tganamur/Tripod-TermProject/TestBuild/Core/Src/main.cpp

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
/* Includes ------------------------------------------------------------------*/
#include "main.h"

/* USER CODE BEGIN Includes */
#include <stdio.h>
#include "bno055.h"
#include "tmc4210.h"
#include  "dcMotorDriver.h"
/* USER CODE END Includes */

I2C_HandleTypeDef hi2c1;

SPI_HandleTypeDef hspi1;
SPI_HandleTypeDef hspi2;

TIM_HandleTypeDef htim1;
TIM_HandleTypeDef htim2;
TIM_HandleTypeDef htim3;

UART_HandleTypeDef huart1;
UART_HandleTypeDef huart2;

/* USER CODE BEGIN PV */
char recvBuf[8] = {0};
char test = 0;
/* USER CODE END PV */

void SystemClock_Config(void);
static void MX_GPIO_Init(void);
static void MX_TIM2_Init(void);
static void MX_USART1_UART_Init(void);
static void MX_SPI1_Init(void);
static void MX_I2C1_Init(void);
static void MX_SPI2_Init(void);
static void MX_TIM1_Init(void);
static void MX_USART2_UART_Init(void);
static void MX_TIM3_Init(void);
/**
  * @brief  The application entry point.
  * @retval int
  */
int main(void)
{
  /* USER CODE BEGIN 1 */
	//HAL_UART_Receive_IT(&huart2, (uint8_t*)recvBuf, 1);
  /* USER CODE END 1 */

  /* MCU Configuration--------------------------------------------------------*/

  /* Reset of all peripherals, Initializes the Flash interface and the Systick. */
  HAL_Init();

  /* Configure the system clock */
  SystemClock_Config();

  /* Initialize all configured peripherals */
  MX_GPIO_Init();
  MX_TIM2_Init();
  MX_USART1_UART_Init();
  MX_SPI1_Init();
  MX_I2C1_Init();
  MX_SPI2_Init();
  MX_TIM1_Init();
  MX_USART2_UART_Init();
  MX_TIM3_Init();
  /* USER CODE BEGIN 2 */
/*!
 * bno055 device address and opmode register address
 * 0x08 -> data to be written into opmode reg. to configure in IMU mode
 */
  HAL_TIM_PWM_Start(&htim1, TIM_CHANNEL_1);
  uint32_t IMU_opmode_addr = 0x3D;
  uint8_t  IMU_mode[1] = {0x08};

  //!uart transmit buffer
  char uart_buf1[128];


  //!create IMU object & associated vars
  bno055* imu;
  imu = new bno055(&hi2c1);
  imu->write(IMU_opmode_addr, IMU_mode, 1);
  int16_t eulx = 0;
  int16_t euly = 0;
  int16_t eulz = 0;

  //!create tmc4210 object & associated vars
  tmc4210* stepper;
  stepper = new tmc4210(&hspi1, &htim1, SPI1_CS1_Pin, EN1_Pin);
  stepper->setup();

  tmc4210* stepper2;
  stepper2 = new tmc4210(&hspi1, &htim1, SPI1_CS2_Pin, GPIO_PIN_12);
  stepper2->setup();

  //!create dcMotor object using struct
  /*
  dcmotor_t panMotor = {TIM_CHANNEL_1, TIM_CHANNEL_2, 0, &htim2};
  enable(panMotor);
  */

  /* USER CODE END 2 */

  /* Infinite loop */
  /* USER CODE BEGIN WHILE */
  int32_t pos = 0;
  int32_t pos2 = 0;
  int32_t curPos = 0;
  int32_t duty = 0;
  while (1)
  {
    /* USER CODE END WHILE */

    /* USER CODE BEGIN 3 */
	  //HAL_UART_Receive_IT(&huart2, (uint8_t*)recvBuf, 1);
	//HAL_UART_Receive(&huart2, recvBuf, 4, 100);
	eulx = imu->read_eul_x();
	euly = imu->read_eul_y();
	eulz = imu->read_eul_z();

	stepper->setPos(pos);
	stepper2->setPos(pos2);
	curPos = stepper->getPos();

	uint16_t uart_buf_len = sprintf(uart_buf1, "Heading: %d deg \r\nRoll: %d deg\r\nPitch: %d deg\r\nTest: %d\r\n\n", eulx, euly, eulz, test);
	HAL_UART_Transmit(&huart1, (uint8_t*)uart_buf1, uart_buf_len, 400);
	HAL_Delay(100);
/*
	setDuty(panMotor, 4000);
	HAL_Delay(500);
	setDuty(panMotor, -4000);
	HAL_Delay(500);
	*/

	/*
	if(eulx == 0 || euly == 0 || eulz == 0){
		HAL_GPIO_WritePin(GPIOA, STATUS_LED_Pin, GPIO_PIN_SET);
	}else{
		HAL_GPIO_WritePin(GPIOA, STATUS_LED_Pin, GPIO_PIN_RESET);
	}
	*/


  }
  /* USER CODE END 3 */
}

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
/* USER CODE BEGIN 4 */
void HAL_UART_RxCpltCallback(UART_HandleTypeDef *huart){
	HAL_UART_Receive_IT(&huart2, (uint8_t*)recvBuf, 1);
	HAL_UART_Transmit(&huart1, (uint8_t*)recvBuf, 8, 400);
}
/* USER CODE END 4 */
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
