tganamur/Tripod-TermProject/TestBuild/Core/Inc/main.h

#define EN1_Pin GPIO_PIN_4
#define EN1_GPIO_Port GPIOA
#define SPI1_CS1_Pin GPIO_PIN_0
#define SPI1_CS1_GPIO_Port GPIOB
#define SPI1_CS2_Pin GPIO_PIN_1
#define SPI1_CS2_GPIO_Port GPIOB
#define SPI1_CS3_Pin GPIO_PIN_2
#define SPI1_CS3_GPIO_Port GPIOB
#define SPI2_CS_Pin GPIO_PIN_12
#define SPI2_CS_GPIO_Port GPIOB
#define STATUS_LED_Pin GPIO_PIN_11
#define STATUS_LED_GPIO_Port GPIOA
